kiavash-at-home/10GHz-DRO/README.md

# Making 10GHz Dielectric Oscillator

I designed and made a 10GHz DRO as Bachlor Degree Final Project in 1997. The circuit is designed, simulated and optimized using SuperCompact. The PCB is drawn by AutoCAD Lite and made using 2 layer PTFE.
