kiavash-at-home/10GHz-DRO/circuit/PCB - 1x.pdf

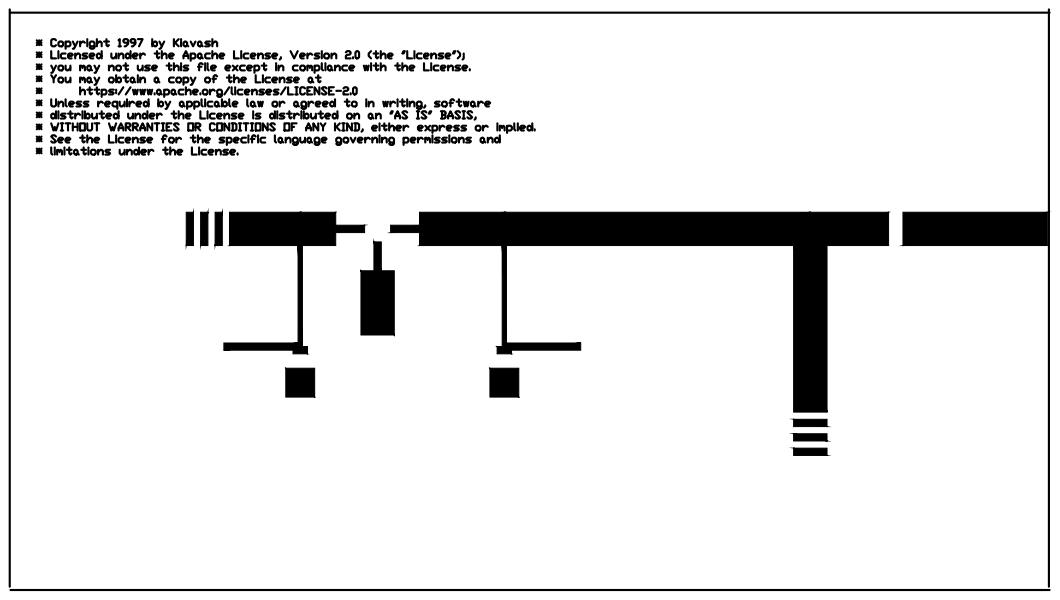
[picture p22: page 1]
