kiavash-at-home/10GHz-DRO/circuit/PCB - Zoomed.pdf

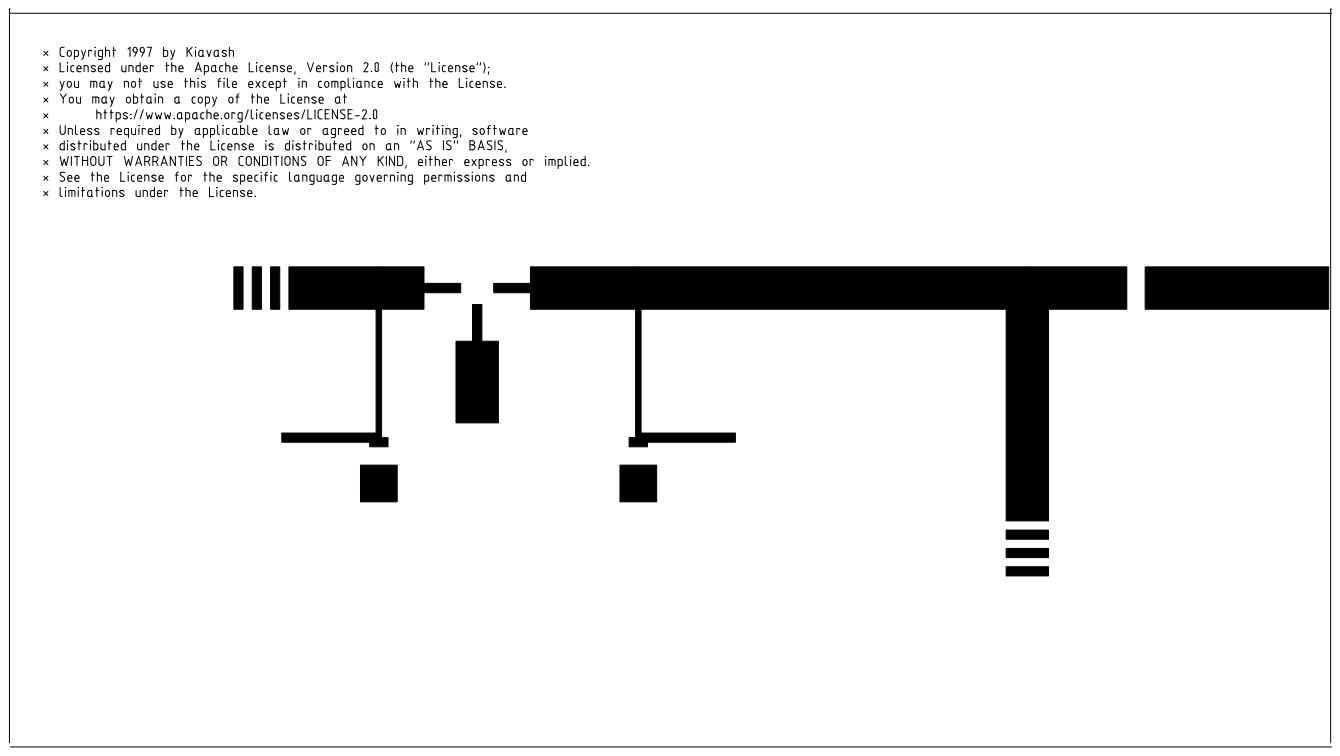
[picture p23: page 1]
