kiavash-at-home/10GHz-DRO/(list of files, cad)

Other CAD files:
circuit/PCB.DWG
